bagdades/postal/doc/cp2102.jpg

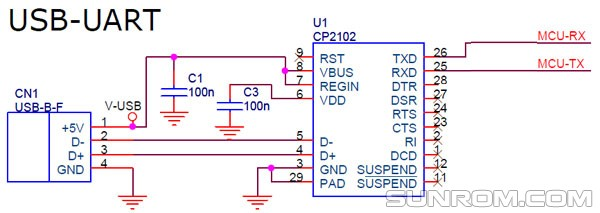
doc/cp2102.jpg
