bagdades/postal/doc/postal_avr_device.gif

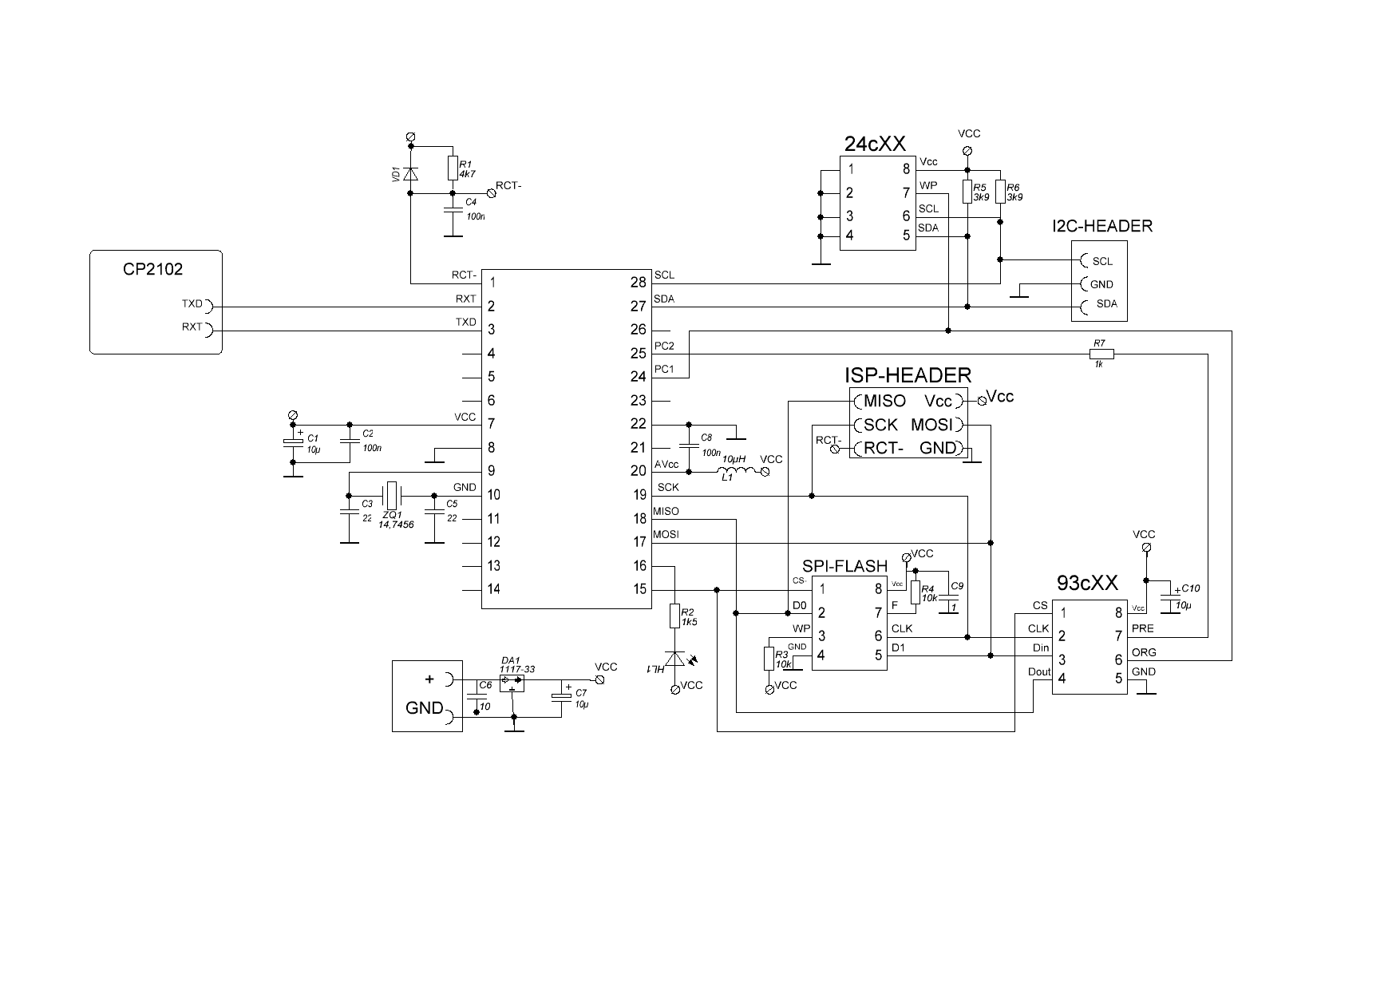
doc/postal_avr_device.gif
