bagdades/postal/doc/postal_avr_device_tqfp.gif

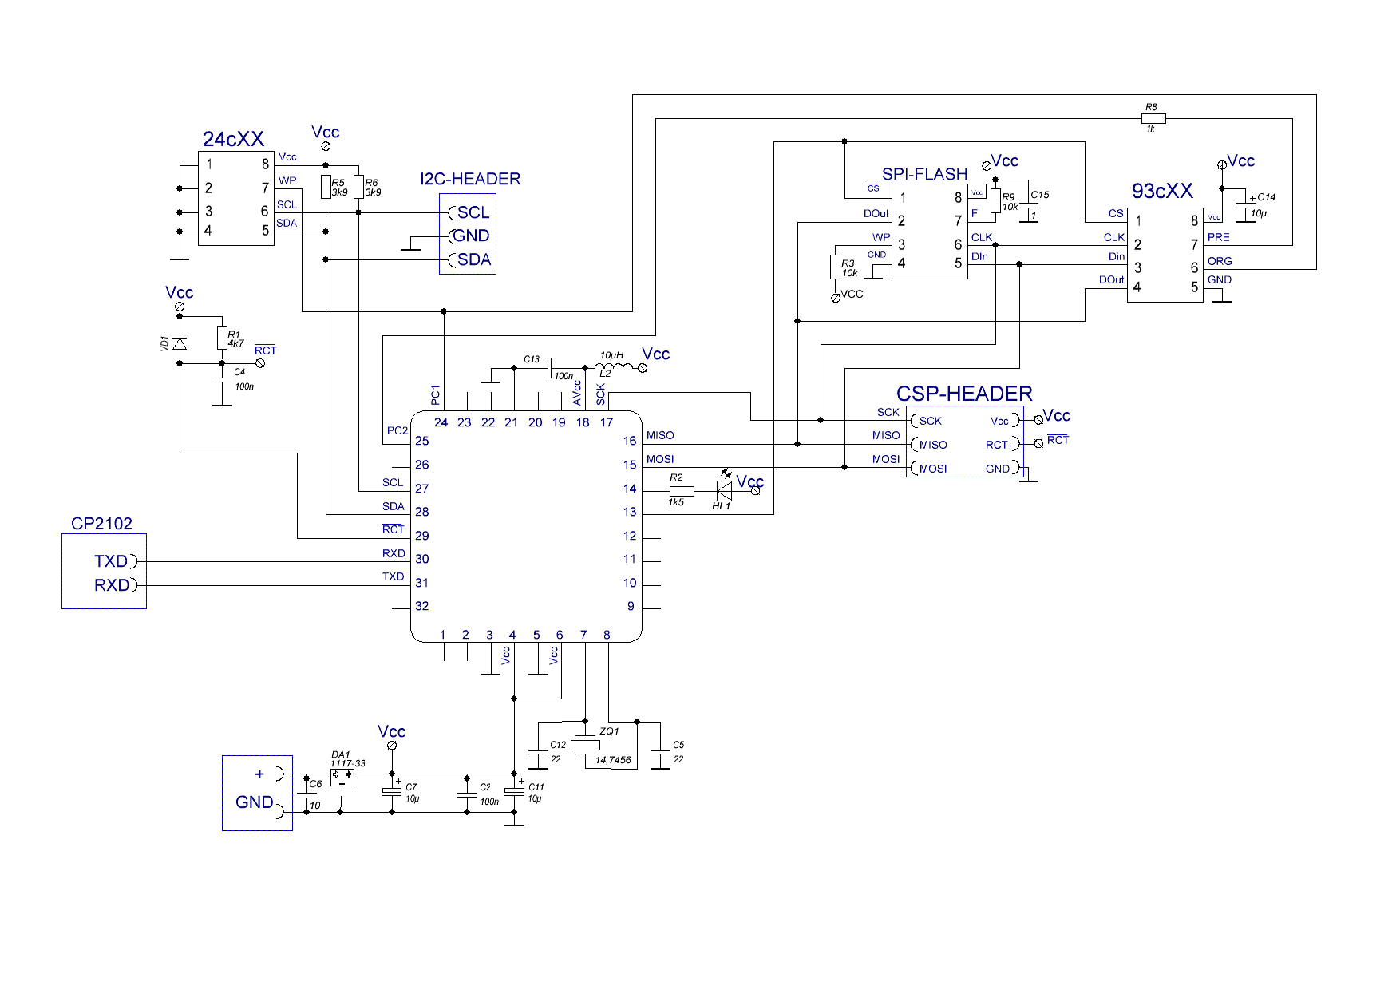
doc/postal_avr_device_tqfp.gif
