bagdades/postal/doc/postal_avr_pcb.tif

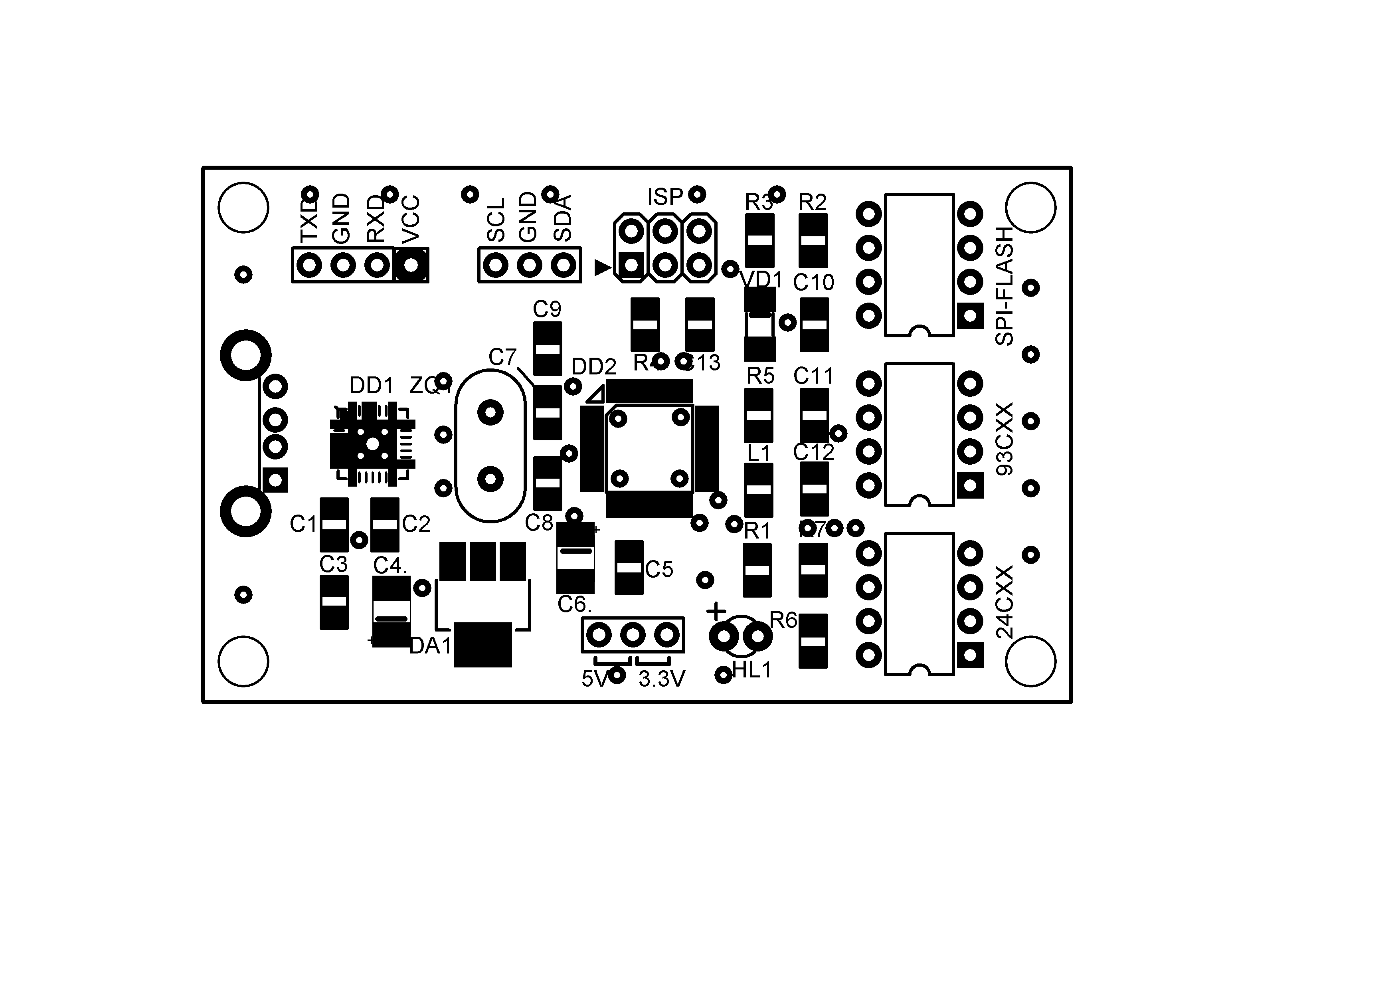
doc/postal_avr_pcb.tif
