bagdades/postal/doc/UT85UnLXqdaXXagOFbXq.jpg

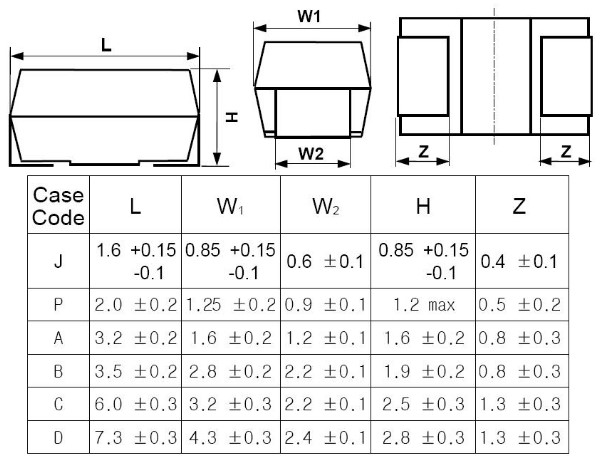
doc/UT85UnLXqdaXXagOFbXq.jpg
