bagdades/postal/doc/Postal2_3. FAQ_сборка_настройка_вопросы_ответы_обсуждения [1].html

(http://master-tv.com)

| Файлы • Ссылки • Прошивки (http://master-tv.com/proshivki/index.php) • Правила • Архив • FAQ • Участники • Поиск

Новых сообщений нет • Профиль • Закладки • Выход [ bagdades ]

Postal2/3. FAQ/сборка/настройка/вопросы/ответы/обсуждения
Список форумов » Телевизоры » ЖК (LCD) | На страницу 1, 2, 3, 4 ... 61, 62, 63, 64 След. Следующая тема · Предыдущая тема

Автор | Сообщение
Михаил__ Участник Сообщения: 535 E-mail Профиль Личное сообщение

31-07-2012 16:11 | цитата

Обсуждаем вопросы по сборке, настройке программатора и прочие особенности по работе с программатором, не имеющие ответов в этом посте.

Вопросы, связанные с усовершенствованием программы (Postal2, Postal3), тестированием решаем здесь http://monitor.net.ru/forum/viewtopic.php?t=317755

Сообщение Администрации :

Проблемы кривых рук, неисправных компов и последствия обычной безграмотности в данной теме НЕ обсуждаются!
ФАРТ

Программаторы предназначены для программирования микросхем памяти непосредственно по протоколам I2C, SPI, MW, или внутрисхемно по протоколам I2C, IСSP и UART
Примечание: Программы "Postal2" и "Postal3" на данный момент не работают с протоколом UART. Использовать сторонние программы.

Postal2 поддерживает девайсы:
1. Tuner PLL
2. EEPROM
3. 3-Wire Serial EEPROM
4. SPI Flash
5. VCT MICRONAS
6. HERCULES (PHILIPS UOC)
7. GENESIS
8. TRIDENT
9. REALTEK
10. NOVATEK
11. MYSON
12. WELTREND
13. MSTAR
14. SAMSUNG S3C866B
15. Atmel AVR
16. FIRMWARE HUB FLASH
17. KB9012, KB9022
18. Dallas EEPROM
19. Эмулятор ИК-ДУ
20. В программе имеется встроенный анализатор шины
Программатор Postal2 работает с системами Win98 (setup_lptdrv_postal2_9x_driver.rar), Win2000, WinXP, Win7 (setup_lptdrv_2000-xp_driver) только на 32 бит

Postal3 поддерживает девайсы:
1. EEPROM
2. 3-Wire Serial EEPROM
3. SPI Flash
4. MSTAR
5. MICRONAS
6. KB9012, KB9022
7. Atmel AVR
8. Эмулятор ИК-ДУ
Программатор Postal3 работает с системами Win2000, WinXP, Win7, Win8 на 32 бит и на 64 бит.

Сборка программатора Postal3. Лично мой опыт:
1. собрал девайс согласно прилагаемой схемы.
2. поставил сразу оба драйвера (из папок VCT и USBXpress)
3. в папку Postal3 поместил программу Postal3 и файл SiUSBXp.dll
4. ткнул девайс в USB (определился сразу)
5. посмотрел номер ком-порта в диспетчере устройств, выставил такой-же в настройках (Settings->COM settings>Postal AVR device setup)
6. вставил что было под рукой (24С02), проверил, пишет - читает
7. утилитой an144sw переключил pid на EA61 - режим USBXpress (EA60 - режим СОМ)
8. заработало.... светодиод замигал

Схема Postal3_AVR в файле postal3_avr_sch.rar

Печатная плата Postal3_AVR в файле postal_avr_pcb.zip

Драйвера для Windows-98 (Postal2) в файле setup_lptdrv_postal2_9x_driver.rar

Драйвера для Windows-2000, Windows-XP (Postal2) в файле setup_lptdrv_2000-xp_driver.rar

Драйвера для WinXP SP3 x32 & Win7 SP1 x64 (Postal2) https://github.com/dmitrystu/LptDrv

Драйвер CP210xVCPInstaller V6.6.1.0 от 10.12.2012 и др (Postal3). http://www.silabs.com/products/mcu/Pages/USBtoUARTBridgeVCPDrivers.asp ...
Драйвер от производителя

Драйвера USBXpress_Install (Postal3) http://www.silabs.com/products/mcu/Pages/USBXpress.aspx
Драйвер от производителя - Download for Windows 2000/XP/Server2003/Vista/Win7 (v3.5.1)

Распаковать и установить драйвера CP210x_VCP_Win_XP_S2K3_Vista_7.exe и USBXpress_Install.exe по умолчанию.

Прошивка для Atmega8/88/168/328 в файле "postalavr_v2_atmel_lic_03-04-2014.rar" Предоставляет возможность внутрисхемного чтение SPI флешь через процессора MSTAR.
Файл в формате HEX

Фьюзы для:
- Atmega8 - Low = AF и High = CF
- Atmega88/168/328 - Low = E7, High = DD, Ext = FD
Как прошить http://www.getchip.net/posts/068-kak-pravilno-proshit-avr-fyuzy-fuse-b ...

Продажа плат от Михаил__ : http://monitor.net.ru/forum/viewtopic.php?t=434754
PID CP2102 переключен на EA61 - режим USBXpress

Дополнительная информация http://monitor.net.ru/forum/documents-service-manual-5.html

Сначала программой Postal2 с "железом" VCT Jig по схеме насадки header_atmega прошивается прошивка Atmega8, затем прошиваются фьюзы. При обновлении прошивки фьюзы повторно прошивать не надо.

Инструкция по сборке, подключению и настройке в файле"postal3-25"
Автор Михаил__

Припаять CP2102. Залудить контакты на плате и "посадить" микросхему феном... паять с флюсом.

Инсталяция программы Postal3. Распаковать программу Postal 3 в папку "Postal 3", поместить файл SiUSBXp.dll, скопировав его из C:\SiLabs\MCU_2\USBXpress\USBXpress_API\Host\x86, а файл postal3_cfg.ini программа создаст сама при первом запуске. В этой же папке будут находиться и считанные программой прошивки.

Изменение масштаба программы : http://monitor.net.ru/forum/viewtopic.php?p=4947981#4947866

Тест на исправность программатора.
-- Проверить соответствие питающих и рабочих напряжений согласно технической документации --
- Если в окне логов есть сообщение об неответе программатора, то проверить правильность установки конфигурации в закладке Setup
- Если программатор не читает в панельках ни один из типов м/сх памяти, то проверьте работу в режиме UART сторонним софтом, заблокировав RESET и подключившись на шины Rx / Tx. Проверить эхо терминалом (писать латиницей).
- Если программатор без проблем читает в панельках EEPROM и SPI, то он рабочий и ищите проблемы в подключениях, или неисправности в испытуемых насадках (шасси, микросхемах).
- Если в панельках EEPROM читает, а SPI нет, или наоборот, то проверьте м/сх SPI (EEPROM) заменой, а также целостность монтажа платы программатора и работу шин при помощи осциллографа.
- Если наблюдается некорректная работа при внутрисхемном чтении/записи, то следует проверить работу при меньшей скорости, или наоборот - при большей, а также уровень питаний, наличие пульсаций по питанию и исправность шин, проверьте ответы анализатору шины, замените кабель USB.
Характерные неисправности при сборке:
а) - не мигает индикатор: 1. Нет питания. 2. Неисправен кварц, или его обвязка. 3. Неисправен, или неправильно запаян светодиод. 4. Неисправна Atmega, или неправильно прошита.
б) - светодиод мигает, в диспетчере устройств видится, но ни один из режимов не работает: 1. Не подпаяна шина СР2102. 2. Неисправна СР2102. 3. "Смотрим в книгу - видим фигу"

Запись мс/х W25P16 или NX25P16
Для совместимости с ними при записи в следующих версиях надо ставить галку 25Q16 mode. Иначе verify даст ошибку на адресе 0

Использование программатора в качестве переходника USB-UART
1. Перевести CP2102 в режим COM.
2. Установить джамперы в позиции 5V и RST-GND.
3. Подключить GND, Rx, Tx к исследуемому устройству.
4. Включить терминальную программу и установить порт

Подключение к КВ9012:
CS --- P59, KS14
SCK--- P60, KS15
SO --- P61, KS15
SI --- P62, KS17

Подключение к Atmel (AtMega) (Схема подключения АТмел для прошивки через разъем ICSP:) http://programmator-ua.ucoz.ru/load/postal_avr_usb_programmator_serial ...

Адаптер для низковольтовых SPI в файле SPI_1v65-1v95

Адаптер для программирования Atnega при помощи Postal2 в файле header_atmega

Программа Postal3 в файле Postal3.rar.
Извлечь в рабочий каталог (папку)

Настройка скорости AVR device: устанавливать 921600, вопрос-ответ http://monitor.net.ru/forum/viewtopic.php?t=317755&postdays=0& ...

Сбросить счетчик:
Settings > Misc > Reset All Backups Counters

Стереть (заполнить FF):
Status > Version, затем Settings > (Unblock) > Erase

Подключение ИК-диода в "Postal2". Катод ИК-диода - на CS, а анод через резистор 33 Ом - на плюс питания.

Подключение ИК-диода в "Postal3". Катод ИК-диода - на CS, а анод через резистор 33 Ом - на PD7 ATmega (pin 11 TQFP-32, или pin 13 PDIP-28), или на плюс питания (временно).

Подключение ФП. ФП вставляется в панельку для SPI. GND - 4, VCC - 8, IROUT - 2

Инструкции по работе и помощь в разработке http://monitor.net.ru/forum/viewtopic.php?t=317755

Отображение программатора в диспетчере устройств
Silicon Labs CP210x USB to UART Bridge (COM3) - PID (EA60)
или
USBXpress Device- PID (EA61)

Изменение PID и устранение проблем:

Изначально от SiLabs имеем экзешник "CP210x_VCP_Win_XP_S2K3_Vista_7.exe".
2. При установке драйвера сначала происходит распаковка его в папку по умолчанию "C:\SiLabs\MCU\CP210x\Windows_XP_S2K3_Vista_7"
3. В этой папке мы имеем нужный нам файл "slabvcp", в котором уже имеется такая запись:
"%USB\VID_10C4&PID_EA60.DeviceDesc%=silabser.Dev, USB\VID_10C4&PID_EA60
%USB\VID_10C4&PID_EA70&Mi_00.DeviceDesc%=silabser.Dev, USB\VID_10C4&PID_EA70&Mi_00
%USB\VID_10C4&PID_EA70&Mi_01.DeviceDesc%=silabser.Dev, USB\VID_10C4&PID_EA70&Mi_01"
которую производитель дал возможность тут (в теме ) модифицировать (изменять, дополнять).
4. Записи из этого файла при УСТАНОВКЕ драйвера пропишутся в системе (где - не знаю, не изучал).
5. Оставите запись в распакованном исходнике драйвера, или нет - системе абсолютно одинаково, поскольку во время работы к этой папке никто уже не обращается и её можно вообще удалить, или переместить всю папку в иное место.
6. Если в Диспетчере устройств в ВИД поставить птицу "Показывать скрытые устройства", то обнаружите, что установленые драйвера от вас никуда не делись после того как "мой девайс был поднят и я по новой поставил заводской драйвер". "Лишние", особенно некорректные, можно удалить.
7. Если у Вас изготовлено несколько устройств на CP2102, или их аналогах, то чтобы наглядно видеть, с каким устройством Вы работаете, следует:
- используя утилиту, присвоить имя девайсу и назначить ему собственный PID.
- в файле slabvcp.inf прописать выбранный Вами PID для данного устройства и (или) имя и установить драйвер.
8. Если Вы забыли PID Вашего устройства, то его можно подсмотреть в Диспетчере устройств. В свойствах выбранного устройства выбрать закладку "Сведения".
Там же можно подсмотреть данные на другие устройства и скачать драйвера здесь http://devid.info/ru/
9. Дописав в файле значение PID под Ваше устройство (подсмотреть в диспетчере устройств) и повторно установив драйвер Вы сможете при помощи утилиты изменить его на нужное.
10. Переключив PID на значение 60 Вы можете использовать Ваш девайс в качестве переходника USB-UART (Rx/Tx) для работы к примеру с MTK Tool, Teraterm и др. Для работы в этом режиме на программаторе следует установить 2 джампера - на 5V и на RST

Сообщение Администрации :

Файлы, прикрепленные ниже, недоступны незарегистрированным пользователям. Для их просмотра следует зарегистрироваться на Форуме в качестве Участника.

postal3-25.rar 352,62 КБ Скачано: 10297 раз(а)
an144sw.zip 296,1 КБ Скачано: 4013 раз(а)
an144sw_old.rar 140,64 КБ Скачано: 2287 раз(а)
setup_lptdrv_2000-xp_driver.rar 75,65 КБ Скачано: 3454 раз(а)
setup_lptdrv_postal2_9x_driver.rar 110,33 КБ Скачано: 2227 раз(а)
SPI_1v65-1v95.jpg 73,05 КБ Скачано: 4165 раз(а)
postalavr_v2_atmel_lic_03-04-2014.rar 13,93 КБ Скачано: 4324 раз(а)
header_atmega.rar 36,67 КБ Скачано: 1835 раз(а)
postal_avr_pcb.zip 14,09 КБ Скачано: 3048 раз(а)
postal2_28-03-2015.rar 449,8 КБ Скачано: 5247 раз(а)
postal3_28-03-2015.rar 305,03 КБ Скачано: 8435 раз(а)
postal3_avr_sch.rar 71,79 КБ Скачано: 3819 раз(а)
PostalAVR_v3b_lice_08-05-2015.rar 13,96 КБ Скачано: 3241 раз(а)
postal3_18-04-2016.rar 353,26 КБ Скачано: 3219 раз(а)

- - - - - - - - -
Работа - не ВОЛК, работа - WORK!
KVI Участник Сообщения: 1725 E-mail Профиль Личное сообщение

31-07-2012 19:39 | цитата

Объясните для чего в настройках сом порта есть: Setting for "Default", Setting for "Second", Postal AVR device setup.
За что отвечает каждая позиция?

- - - - - - - - -
-=Vladimir=-
Михаил__ Участник Сообщения: 535 E-mail Профиль Личное сообщение

31-07-2012 19:52 | цитата

KVI писал:

Объясните для чего в настройках сом порта есть: Setting for "Default", Setting for "Second", Postal AVR device setup.
За что отвечает каждая позиция?

там важна только нижняя (Postal AVR device setup), остальные две по-барабану что ставить, они типа "на будущее оставлены..." это к автору вопрос.

- - - - - - - - -
Работа - не ВОЛК, работа - WORK!
Captain monitor.net.ru Сообщения: 9772 E-mail Профиль Личное сообщение

04-08-2012 17:28 | цитата

karteji писал:

Captain, а верификация показывает если коряво записалось где бок? просто никогда не сталкивался. и еще не знаю как прога postal3 пишет 25ххх.

пока ищу кроватки с цангами, проверял считывание и запись МС 25F80. Пока МС стояла верно, верификация шла корректно (индикатор процентовки полз). Как палец устал, сразу выскочило "Ошибка верификации" и прога остановилась. Для проверки качества записи этого достаточно. Если хочеш знать где и почему - тогда твой метод нескольких считываний и сверки побитно имеет смысл, но для уже работы уже не имеет смысла --- прошивка неверная!!!

karteji писал:

еще не знаю как прога postal3 пишет 25ххх. если обьём флеши больше прошивы он не пишет по кругу?

ВОТ ТУТ И ДАВАЙТЕ ПРОВЕРЯТЬ!!!! Володя ЧЕЛОВЕК с большой буквы, но ты сам подумай: он все может сделать сам? Вот с тебя и тесты программы на ошибки. Сдесь можно писать отчеты.
Единственно что нашел в свое время в проге Postal2: при записи ЕЕПРОМ и наличии дампа размером меньше чем микросхема, микросхема не будет стерта вся. Т.е. записано будет поле на которую расчитан дамп, остальное останеться без изменений. В отличие от других программаторов - они сотрут всю микросхему перед записью!!! Это надо знать и иметь ввиду. Думаю что это имеет свой смысл

andros писал:

Игорь , брось это в шапку темы . Там уместней будет

Я брошу, но давай Михаила обяжем - нашел зерно интересное, вставь себе для лентяев!!! Хотя, когда тема опухнет, искать будет влом даже мне

Сообщение Администрации :

Уважаемые пользователи программы POSTAL3, для развития самой программы, а так же для поддержки друг друга в технической помощи, давайте создавать HELP для этой программы!!!

У меня есть следующая мысль: берем в руки МС или внутрисистемно шьем. Если в руках - описываем куда воткнули, если внутрисистемно - описываем куда воткнулись и как (можно кратко аппарат). Любое движение мышкой описываем словами, или управления или отчет программы можно сопровождать картинками программы. Оформляем эти комиксы/манга в формате вордовского документа мне или любому желающему (выставляйте свои кандидатуры в инициативную группу). Конвертируем в ПДФ, редактируем доступным языком выкладываем в первом посту. Обсудили что все добро - опускаем в файлообменник и оставляем ссылку в первом посту.
Если первый пост не почитали, можно баны раздавать будет
vladim-colinux Участник Сообщения: 262 Профиль Личное сообщение

04-08-2012 23:12 | цитата

karteji писал:

а верификация показывает если коряво записалось где бок?

1-ищем проблемы в железе;
a) - проверяем работоспособность железа (непропай,наличие контакта ,замыкание дорожек ,наличие сигналов)
2 - пробуем на другой микросхеме (если пишется и читается без ошибок то пишем в тему автора Postal2 (не забывая указать её название и прикрепить лог)

По проге реально сейчас всё и по установке и по применению досконально расписано в разделе автора и в этом.Дополнительно создавать коллаж из картинок по каждому шасси и аппарату считаю вредным ( надо же самому хоть что-то делать )

- - - - - - - - -
профессионально сломаю любую без возможности восстановления
krahobor Участник Сообщения: 185 E-mail Профиль Личное сообщение

05-08-2012 15:28 | цитата

Добрый день. Подойдёт ли с такой маркировкой "МЕГА" для сего девайса? Собрался заказать...
IC ATMEL QFP-32 ATMEGA8A-AU

- - - - - - - - -
Задаю идиотские вопросы...ИЗВИНИТЕ...
Евгений373 Гость 46.159.*.*

05-08-2012 21:14 | цитата

krahobor, подойдёт, ставь смело
karteji Предупреждений: 1 Сообщения: 298 E-mail Профиль Личное сообщение

06-08-2012 09:43 | цитата

Captain писал:

Единственно что нашел в свое время в проге Postal2: при записи ЕЕПРОМ и наличии дампа размером меньше чем микросхема, микросхема не будет стерта вся. Т.е. записано будет поле на которую расчитан дамп, остальное останеться без изменений. В отличие от других программаторов - они сотрут всю микросхему перед записью!!! Это надо знать и иметь ввиду. Думаю что это имеет свой смысл

вот уже что то есть. просто для таких случаев нужен дамп FFки. а это можно даже в понике сделать. там есть пунктик "утилиты" -- "очистить буфер" и сохраняем как чистую. записал FF а потом любую прошивку. и не будет "при записи ЕЕПРОМ и наличии дампа размером меньше чем микросхема, микросхема не будет стерта вся. Т.е. записано будет поле на которую расчитан дамп, остальное останеться без изменений." (ну или пока не исправят прогу.) вот в таких случаях мой метод с тоталом думаю поможет. (можно будет узнать почему не прошла верификация).
Михаил__ Участник Сообщения: 535 E-mail Профиль Личное сообщение

06-08-2012 10:10 | цитата

попалась в руки М6М80011
пишется-читается без проблем на MaxSpeed и при 3.3В
выбирать нужно вручную (без галки "Auto")

Using Manual Set .
Selected M6M80011 .
Connection opened .
- holding pin 7 up .
- data 16 bit .
- Null-Bit Not Used .
Saved 128 bytes .
"Auto" = Combined Mode .
Connection already opened.
- Null-Bit Not Used .
EEPROM Verify 128 OK
usb-device closed.
Connection already closed.

а стирать чип можно в "Settings" -
Unblock->Erase
в I2C - просто кнопка Erase (без Unblock)

- - - - - - - - -
Работа - не ВОЛК, работа - WORK!
Captain monitor.net.ru Сообщения: 9772 E-mail Профиль Личное сообщение

06-08-2012 10:19 | цитата

karteji писал:

ну или пока не исправят прогу.) вот в таких случаях мой метод с тоталом думаю поможет.

не исправят. Мы решили что это интересный плюс! К примеру дамп ээпромки, поставляемая сони, при записи не затирает серийный номер аппарата. Что является плюсом. Просто знать надо...
asanik monitor.net.ru Сообщения: 6455 E-mail Профиль Личное сообщение

06-08-2012 11:54 | цитата

karteji писал:

просто для таких случаев нужен дамп FFки. а это можно даже в понике сделать

Не нужно ни ПОНИ ни FF дамп - все ТУТ в Вовиной делается - >> I2C eeprom >> Settings >> EEPROM >> Erase - и ВСЕ! - весь массив FF.
Есть только одно НО! - Нужно это делать считав предварительно EEPROM или записав в нее что либо,

Добавлено: либо определить память - кликнуть >> Version

Если этого не сделать - появляется надпись -

Connection opened .
Need version check .
usb-device closed.

Или

SiUSBXp.dll loaded .
New style Dll in use ...
Count of USB-devices = 1
Num of device to use = 0
Connection opened .
Need version check .
usb-device closed.

Я так понял, что проге нужно сначала определить что ей подсунули - идентифицировать память.

При стирании так -

Erase.JPG 41,99 КБ Скачано: 1888 раз(а)

- - - - - - - - -
...каждый живет так, как он того заслуживает...
..."косить бабки" и зарабатывать - разные вещи... (KRAB monitor.net.ru)
cherser5 Участник Сообщения: 191 E-mail Профиль Личное сообщение

06-08-2012 12:05 | цитата

asanik писал:

Нужно это делать считав предварительно EEPROM или записав в нее что либо...
Я так понял, что проге нужно сначала определить что ей подсунули - идентифицировать память.

Для этого есть кнопочка Version
asanik monitor.net.ru Сообщения: 6455 E-mail Профиль Личное сообщение

06-08-2012 12:27 | цитата

karteji писал:

25хх позксперемантирую над ней отпишусь.

С 25хх - то что Игорь писал, думаю не прокатит по их концепции - она целым дампом пишется и стирается вся перед записью.
Это EEPROM можно редактировать и ячейками дописывать-изменять, а флэху только полностью всем дампом.

- - - - - - - - -
...каждый живет так, как он того заслуживает...
..."косить бабки" и зарабатывать - разные вещи... (KRAB monitor.net.ru)
karteji Предупреждений: 1 Сообщения: 298 E-mail Профиль Личное сообщение

06-08-2012 12:33 | цитата

asanik, не знаю насчет редактировать- не делал.. когда спи-тт писал то дамп обрезал. (там выставляли обьем в 2 раза больше и считывали.(не я) и получалось что 2 раза повторялась прошива. в этом случае в редакторе обрезал.
Михаил__ Участник Сообщения: 535 E-mail Профиль Личное сообщение

06-08-2012 13:49 | цитата

asanik писал:

все ТУТ в Вовиной делается - >> I2C eeprom >> Settings >> EEPROM >> Erase - и ВСЕ! - весь массив FF.
Есть только одно НО! - Нужно это делать считав предварительно EEPROM или записав в нее что либо,

во всех остальных (включая "others"!) тоже самое есть
Да, перед стиранием надо чтобы прога память разнюхала сначала.

- - - - - - - - -
Работа - не ВОЛК, работа - WORK!
Михаил__ Участник Сообщения: 535 E-mail Профиль Личное сообщение

06-08-2012 23:42 | цитата

изначально джампер планировался просто "переключательный", который перекидывал питание то на вход, то на выход. Именно на замыкании настоял Postal2, видимо, были на это причины
Кстати, не предусмотрена защита от КЗ по питанию. Можно просто в разрыв 5В USB включить самовосстанавливающийся предохранитель. ИМХО не помешает.

- - - - - - - - -
Работа - не ВОЛК, работа - WORK!
Евгений373 Гость 46.159.*.*

07-08-2012 07:10 | цитата

У кого-то видел в Вовиной теме в самоделке, индикацию- 3,3/5 вольт и тумблер на питание меги, тоже был-бы весьма не лишним.
asanik monitor.net.ru Сообщения: 6455 E-mail Профиль Личное сообщение

07-08-2012 07:25 | цитата

Михаил__ писал:

включить самовосстанавливающийся предохранитель

Миш, самовосстанавливающиеся полимеры не стоит применять... Лично я им особо не доверяю - у них ограниченное количество циклов срабатывания, потом они начинают мозг парить.

- - - - - - - - -
...каждый живет так, как он того заслуживает...
..."косить бабки" и зарабатывать - разные вещи... (KRAB monitor.net.ru)
Captain monitor.net.ru Сообщения: 9772 E-mail Профиль Личное сообщение

07-08-2012 07:38 | цитата

asanik писал:

Лично я им особо не доверяю - у них ограниченное количество циклов срабатывания, потом они начинают мозг парить.

возми любую мать, на ней на выходах питания USB стоят зелененькие преды. Чем они плохи? у меня уже пару раз в матери отрабатывал (плееров море через меня идет, некоторые замкнутые или сломанные штекера). И ниче не жалуюсь. Если хош - дохлые матери посмотри. Найди пред который меньше по току, чем в матери и вперед.
asanik monitor.net.ru Сообщения: 6455 E-mail Профиль Личное сообщение

07-08-2012 07:40 | цитата

Я вот над чем думал - кто первым микры "вверх ногами" сунет - каков сценарий будет? В принципе это неизбежно случится особенно на переходнике-вертолетике под SMD даже боком умудряться воткнуть.

Добавлено 07-08-2012 07:49

Captain писал:

стоят зелененькие преды

Игорь, так эти полимеры почти на любом T-CONе и инверторе применяются - они и есть самовостанавливающиеся, просто мало кто знает об этом.
http://www.multifuse.ru/pdf/wayon/lp-nsm.pdf
http://www.multifuse.ru/pdf/wayon/lp-ism.pdf

Captain писал:

Чем они плохи?

Тем, что изменяют свое сопротивление ("зависают") и довольно часто. Тем, что их сопротивление увеличивается с ростом окружающей температуры (с нагревом). Еще и тем, что инертны и критичны к напряжению. И тем, что количество регенерирующих циклов у них ограничено (у некоторых типов оно невелико и достигает лишь нескольких десятков срабатываний).

Если наглядно - достаточно погреть их феном или паяльником до 80-100 градусов и померить. После некорректной пайки возникают необратимые последствия.
Простой пример: достаточно вспомнить сколько их перегоревших и "потёкших" - уйма, а ведь он самовосстанавливающийся.
Тогда, собственно, напрашивается вопрос - какого хрена он не восстанавливился последний раз? Не захотел - надоело!

http://www.chipdip.ru/video.aspx?vid=ID000293063
http://www.chipdip.ru/video.aspx?vid=ID000261599
Остальное чуть позже - я темку про них готовлю.
Вот тут их кучка - http://www.multifuse.ru/

- - - - - - - - -
...каждый живет так, как он того заслуживает...
..."косить бабки" и зарабатывать - разные вещи... (KRAB monitor.net.ru)
Captain monitor.net.ru Сообщения: 9772 E-mail Профиль Личное сообщение

07-08-2012 11:08 | цитата

asanik писал:

самовосстанавливающиеся полимеры не стоит применять

Уже изнасиловал с матери вот такой. Грел и жег феном (до 280град), отпаял и припаял, током пробил 3 раза. Востанавливается добро. Саня чтот ты не то смотриш.
Михаил__ Участник Сообщения: 535 E-mail Профиль Личное сообщение

07-08-2012 12:16 | цитата

Captain писал:

Уже изнасиловал с матери вот такой. Грел и жег феном (до 280град), отпаял и припаял, током пробил 3 раза. Востанавливается добро.

Вот именно такие я и имел в виду. Они ИМХО надежнее чем остальные.

- - - - - - - - -
Работа - не ВОЛК, работа - WORK!
asanik monitor.net.ru Сообщения: 6455 E-mail Профиль Личное сообщение

07-08-2012 13:20 | цитата

Captain писал:

Саня чтот ты не то смотриш.

То.. тО! Твой вот - http://www.multifuse.ru/pdf/keter/smd_1206.pdf

- - - - - - - - -
...каждый живет так, как он того заслуживает...
..."косить бабки" и зарабатывать - разные вещи... (KRAB monitor.net.ru)
Captain monitor.net.ru Сообщения: 9772 E-mail Профиль Личное сообщение

07-08-2012 13:36 | цитата

не он. корпус явно не 1206, а больше, намного больше. но не в этом соль. Есть возможность сделать защиту. Тут пусть каждый сам думает. Собрать электронный предохранитель не составит труда.
asanik monitor.net.ru Сообщения: 6455 E-mail Профиль Личное сообщение

07-08-2012 13:46 | цитата

Captain писал:

но не в этом соль.

Ну да, собственно, принцип тот же.

Игорь, ты про цанговые панельки писал, что ищешь. Я их взял, а вот ставить не стал...Попробовал - в нее цанга в цангу не ЛЭЗЕ (не лезет) - мне это не понравилось тем, что переходник-вертолетик под SMD уже не вставишь в цангу. Поставил обычные лепестковые, а уже в них цанговые вонзил. Сделал это из соображений подключения зажима (клипсы) для удобства и универсальности.

Поэтому вопрос: кто нибудь думал как приспособить клипсу к девайсу?

- - - - - - - - -
...каждый живет так, как он того заслуживает...
..."косить бабки" и зарабатывать - разные вещи... (KRAB monitor.net.ru)
andros Железный Оленевод Сообщения: 18120 Профиль Личное сообщение

07-08-2012 14:07 | цитата

asanik писал:

Поэтому вопрос: кто нибудь думал как приспособить клипсу к девайсу?

http://remont-aud.net/forum/90-18014-1

- - - - - - - - -
....и канифоли дух ,ласкает нюх .. -неизвестный аффтор .
asanik monitor.net.ru Сообщения: 6455 E-mail Профиль Личное сообщение

07-08-2012 14:25 | цитата

Андрюх, пасиб! Думаю пригодится многим и твоя ссылка - http://remont-aud.net/forum/90-18014-1
Я хотел обсудить - как со стороны платы девайса кто и как думает её конектить.

Я такую взял попробовать -

- - - - - - - - -
...каждый живет так, как он того заслуживает...
..."косить бабки" и зарабатывать - разные вещи... (KRAB monitor.net.ru)
andros Железный Оленевод Сообщения: 18120 Профиль Личное сообщение

07-08-2012 14:28 | цитата

asanik, Куйня . Была такая , пружина сильная , пластмасовые края меж контактами быстро заламываются . Короче микрух на 50 , и можно выкидывать .

- - - - - - - - -
....и канифоли дух ,ласкает нюх .. -неизвестный аффтор .
asanik monitor.net.ru Сообщения: 6455 E-mail Профиль Личное сообщение

07-08-2012 14:33 | цитата

andros, посчитаю - скажу. Надо счетчик будет примастырить тогда. Они разные - эти с положительными отзывами... Время покажет... счетчик тоже.

Добавлено 07-08-2012 14:42

andros, вот нашел из твоей ссылки - http://www.c-u-s.co.uk/soic-clips-/-isp-leads/3m-soic-/-sop-16-way-tes ...

- - - - - - - - -
...каждый живет так, как он того заслуживает...
..."косить бабки" и зарабатывать - разные вещи... (KRAB monitor.net.ru)
andros Железный Оленевод Сообщения: 18120 Профиль Личное сообщение

07-08-2012 14:45 | цитата

asanik, Я же к переходнику , навроде Михаиловского примастырил клипсы из PCI слота . Силы усилия ножек кусочков слота , хватает удерживать микру , и контакт нормальный . Да и расходник не дорогой , со слота можно напилить ещё ! Завтра если не забуду , фотку сделаю .

- - - - - - - - -
....и канифоли дух ,ласкает нюх .. -неизвестный аффтор .
Captain monitor.net.ru Сообщения: 9772 E-mail Профиль Личное сообщение

07-08-2012 15:56 | цитата

У меня круче будет. http://remont-aud.net/forum/90-18014-216602-16-1344340416 Счас стоит вопрос о том как снять и адаптировать под плату программатора. Чтоб бутер аккуратный был. Сделаю - нахвастаюсь обязательно.
cherser5 Участник Сообщения: 191 E-mail Профиль Личное сообщение

07-08-2012 16:48 | цитата

Captain писал:

опиши процесс секса по установке и работе (если было)

Не было никаких дополнительных совокуплений. Стандартная установка драйверов из комплекта, железо - в USB-порт и вперёд! А вот Postal2 под х64 так и не удалось запустить. Не видит драйвер LPT, хоть тот и установлен.
Быстрый ответ
Смайлики: показать все | Цитировать Русская клавиатура
| Настройки Цитировать последнее сообщение Присоединить подпись (подпись можно изменять в профиле) Сообщать мне о получении ответа

Список форумов » Телевизоры » ЖК (LCD) | Следующая тема · Предыдущая тема На страницу 1, 2, 3, 4 ... 61, 62, 63, 64 След. Следить за ответами в теме Добавить в закладки Версия для печати

Перейти: Похожая информация: Способы обновления ПО. Схемы, ссылки, обсуждения. Postal2/3. Делаем свой софт для работы.Поддержка и сбор инфы 32 LCD TV «Китаец» Вопросы по БП PHILIPS 40PFL3107H/60 сборка матрицы Организационные вопросы по работе мастерской. | Вы можете начинать темы Вы можете отвечать на сообщения Вы можете редактировать свои сообщения Вы можете удалять свои сообщения Вы можете голосовать в опросах Вы можете добавлять файлы Вы можете скачивать файлы

(http://b.efind.ru/www/delivery/ck.php)

(http://top100.rambler.ru/top100/Electronics/)
