bagdades/postal/postal/postal-brd.pdf

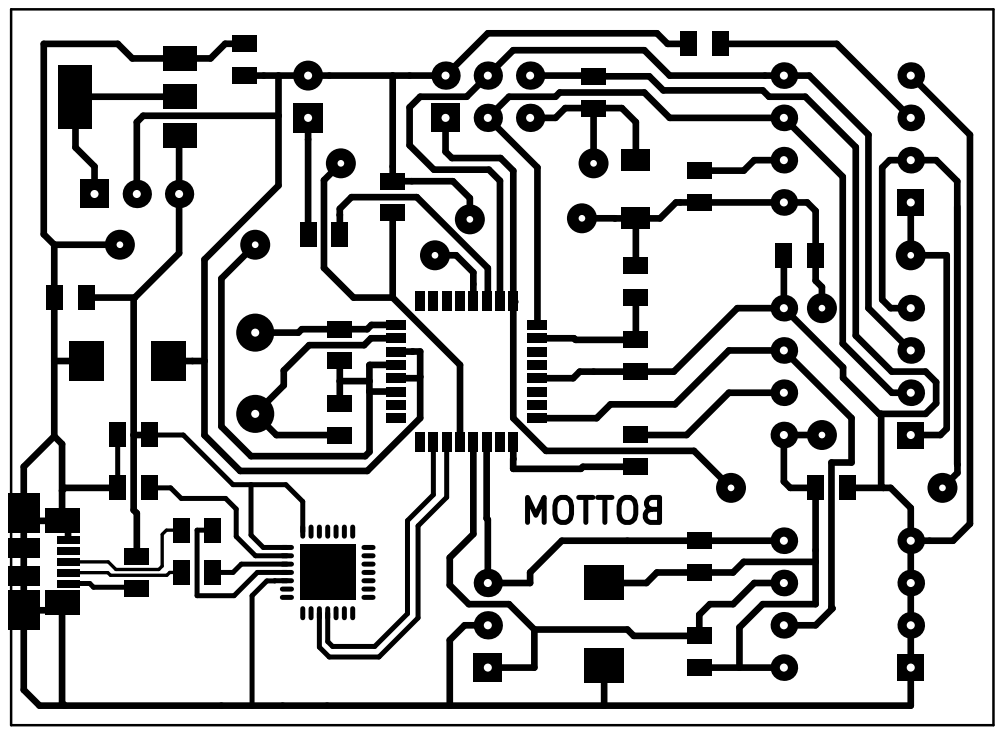
[picture p11: page 1]
