bagdades/postal/postal/postal-brdT.pdf

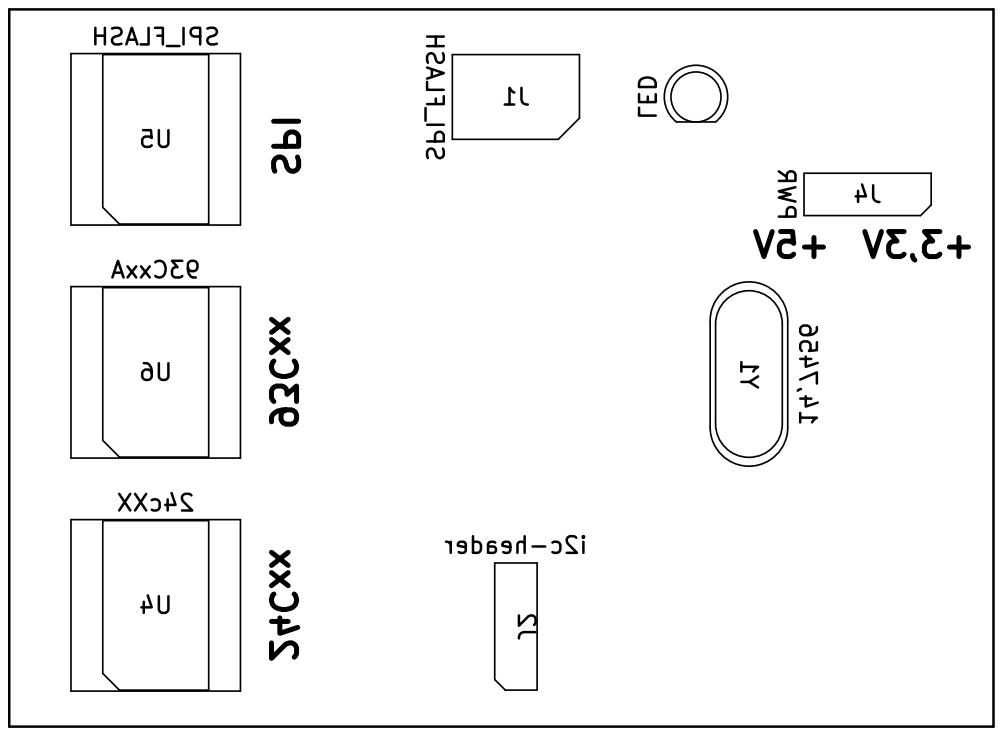
[picture p12: page 1]
