bagdades/postal/postal/postal.kicad_pcb

## KiCad design postal/postal.kicad_pcb (2018-01-23)

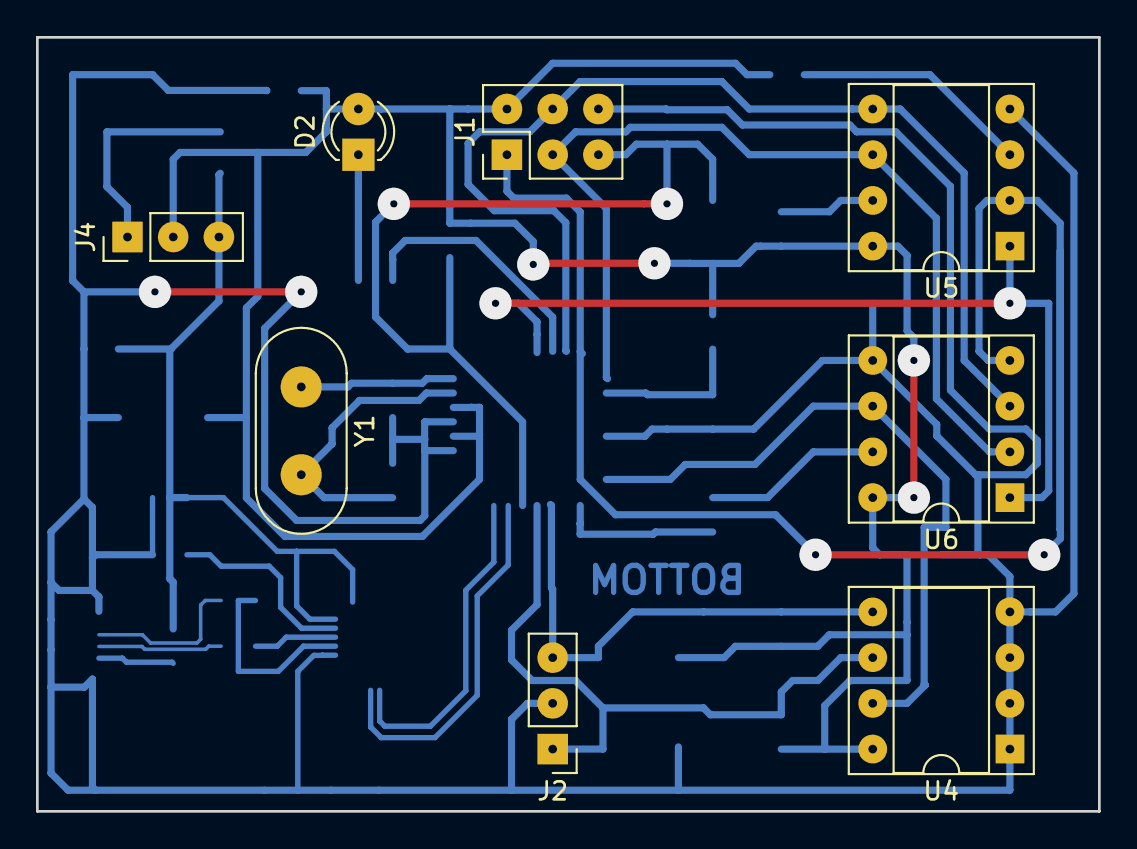
[picture p13: board postal.kicad_pcb from above]

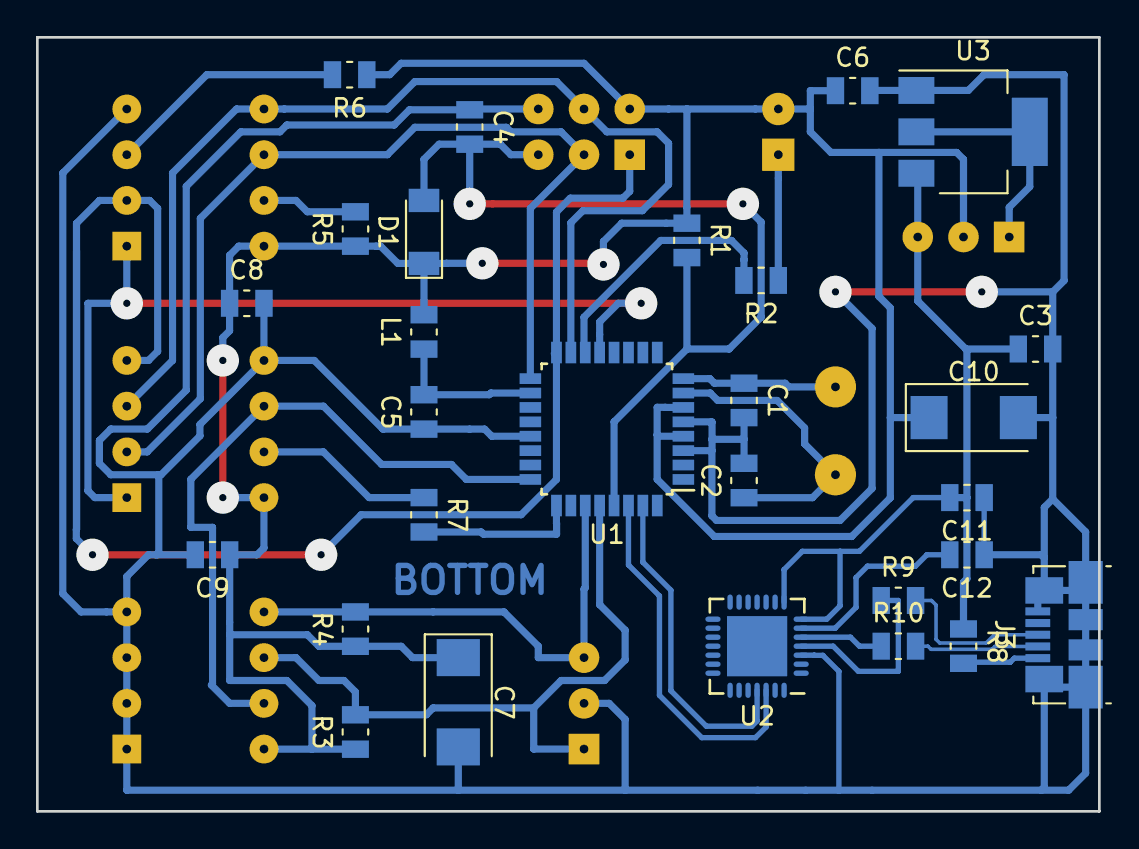
[picture p14: board postal.kicad_pcb from below]

Board: 2 copper layers, 59.0 x 43.0 mm, 36 parts (28 on the bottom side), 29 nets.

Parts:
C1, C2: 22p; C_0805_2012Metric
C3, C4, C5, C6, C8, C9, C11, C12: 100n; C_0805_2012Metric
C7, C10: 10u; CP_EIA-6032-28_Kemet-C
D1: D; D_MiniMELF
D2: LED; LED_D3.0mm
J1: SPI_FLASH; PinHeader_2x03_P2.54mm_Vertical
J2: i2c-header; PinHeader_1x03_P2.54mm_Vertical
J3: USB_B_Micro; USB_Micro-B_Molex_47346-0001
J4: PWR; PinHeader_1x03_P2.54mm_Vertical
L1: 10u; L_0805_2012Metric
R1: 4k7; R_0805_2012Metric
R2: 1k5; R_0805_2012Metric
R3, R4: 3k9; R_0805_2012Metric
R5, R6: 10k; R_0805_2012Metric
R7: 1k; R_0805_2012Metric
R8: 0; R_0805_2012Metric
R9, R10: 30; R_0805_2012Metric
U1: ATMEGA8-16AU; LQFP-32_7x7mm_P0.8mm
U2: CP2102; QFN-28-1EP_5x5mm_P0.5mm
U3: AP1117-33; SOT-223-3_TabPin2
U4: 24cXX; DIP-8_W7.62mm_Socket
U5: SPI_FLASH; DIP-8_W7.62mm_Socket
U6: 93CxxA; DIP-8_W7.62mm_Socket
Y1: 14,7456; Crystal_HC49-4H_Vertical

Connections:
/MISO: J1.1, U1.16, U5.2, U6.4
/MOSI: J1.4, U1.15, U5.5, U6.3
/RES: C4.2, D1.2, J1.5, R1.2, U1.29
/RX: U1.30, U2.26
/SCK: J1.3, U1.17, U5.6, U6.2
/SCL: J2.1, R3.2, U1.28, U4.6
/SDA: J2.3, R4.2, U1.27, U4.5
/TX: U1.31, U2.25
GND: C1.2, C2.2, C3.2, C4.1, C5.1, C6.2, C7.2, C8.2, C9.2, C10.2, C11.1, C12.1, J1.6, J2.2, J3.5, J3.6, U1.3, U1.5, U1.21, U2.3, U3.1, U4.1, U4.2, U4.3, U4.4, U5.4, U6.5
unnamed: C1.1, U1.8, Y1.1
unnamed: C2.1, U1.7, Y1.2
unnamed: C5.2, L1.1, U1.18
unnamed: C3.1, C11.2, J4.3, R8.1, U2.7, U2.8, U3.3
unnamed: C12.2, U2.6
unnamed: D2.1, R2.1
unnamed: J3.1, R8.2
unnamed: J3.2, R10.2
unnamed: J3.3, R9.2
unnamed: J4.1, U3.2
unnamed: R2.2, U1.14
unnamed: R5.2, U5.7
unnamed: R6.2, U5.3
unnamed: R7.1, U6.7
unnamed: R7.2, U1.25
unnamed: R9.1, U2.4
unnamed: R10.1, U2.5
unnamed: U1.13, U5.1, U6.1
unnamed: U1.24, U4.7, U6.6
VCC: C6.1, C7.1, C8.1, C9.1, C10.1, D1.1, D2.2, J1.2, J4.2, L1.2, R1.1, R3.1, R4.1, R5.1, R6.1, U1.4, U1.6, U4.8, U5.8, U6.8
