bagdades/postal/(commit log)

2018-01-15 Update pcb
    [postal.kicad_pcb]
2018-01-16 Create pcb
    [postal.kicad_pcb, postal.sch]
2018-01-18 Final pcb
    [postal.kicad_pcb, postal.sch]
2018-01-19 Print pcb
    [postal.kicad_pcb, postal.sch]
